vroland/epdiy/hardware/ed133ut2_connector/ed133ut2_connector.kicad_pcb

## KiCad design hardware/ed133ut2_connector/ed133ut2_connector.kicad_pcb (2020-07-25, last stored version)

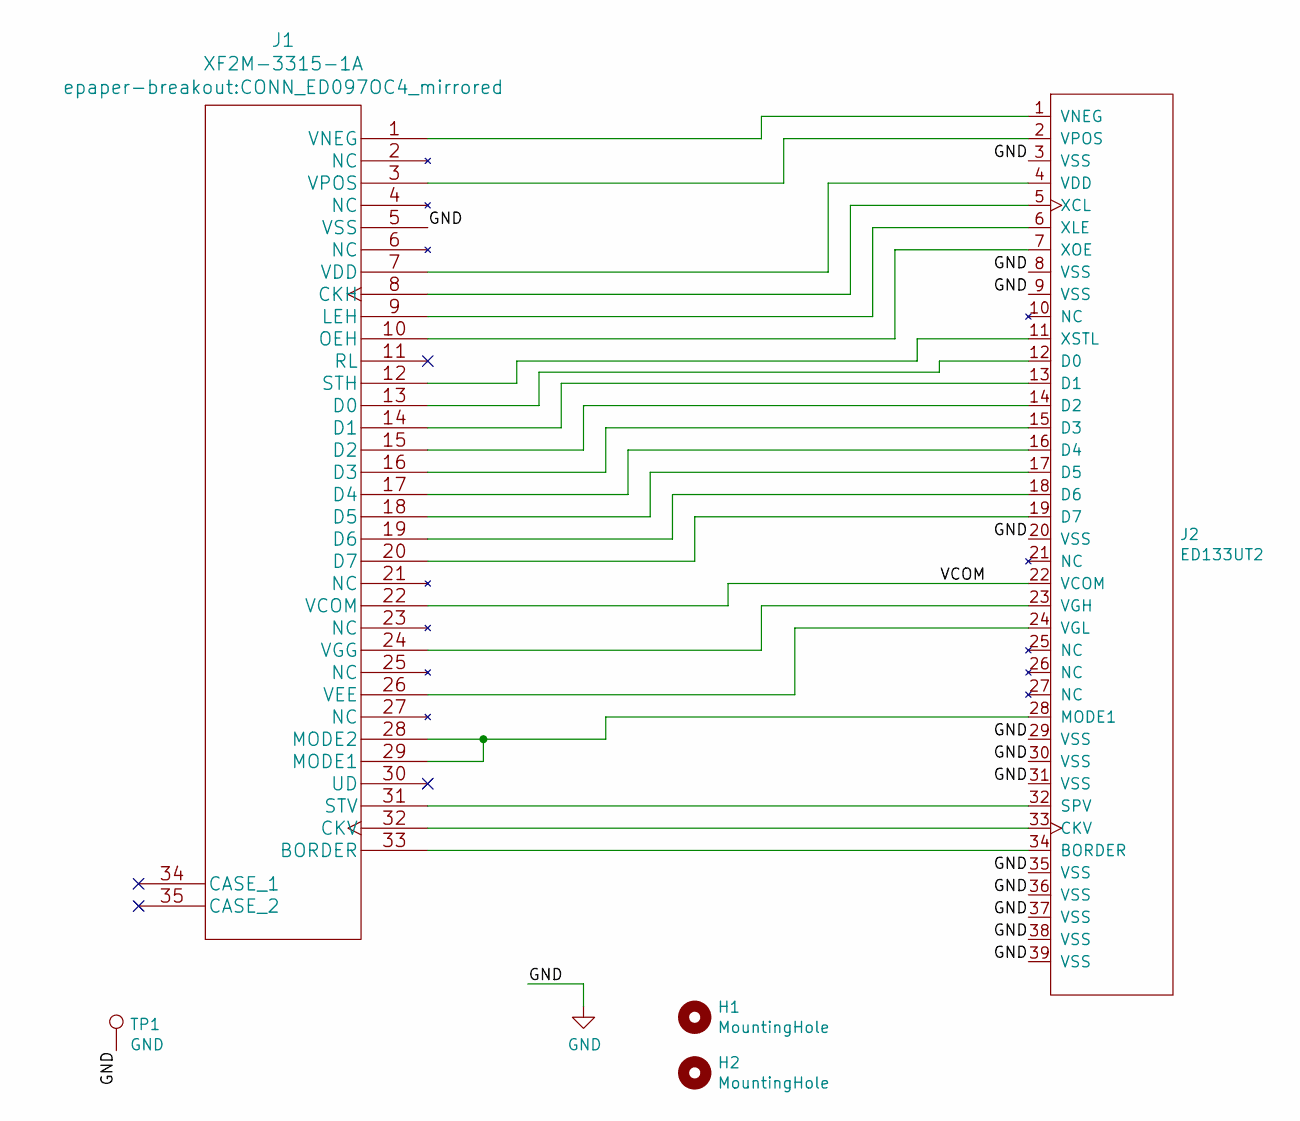
[picture p7: schematic ed133ut2_connector.sch]

Parts:
H1, H2: MountingHole; MountingHole_2.2mm_M2
J1: XF2M-3315-1A; CONN_ED097OC4_mirrored
J2: ED133UT2; HRS_FH26W-39S-0.3SHW(60)
TP1: GND; TestPoint_Pad_D2.0mm

Connections:
/VCOM: J1.22 (VCOM), J2.22 (VCOM)
GND: J1.5 (VSS), J2.3 (VSS), J2.8 (VSS), J2.9 (VSS), J2.20 (VSS), J2.29 (VSS), J2.30 (VSS), J2.31 (VSS), J2.35 (VSS), J2.36 (VSS), J2.37 (VSS), J2.38 (VSS), J2.39 (VSS), TP1.1
unnamed: J1.1 (VNEG), J2.1 (VNEG)
unnamed: J1.3 (VPOS), J2.2 (VPOS)
unnamed: J1.7 (VDD), J2.4 (VDD)
unnamed: J1.8 (CKH), J2.5 (XCL)
unnamed: J1.9 (LEH), J2.6 (XLE)
unnamed: J1.10 (OEH), J2.7 (XOE)
unnamed: J1.12 (STH), J2.11 (XSTL)
unnamed: J1.13 (D0), J2.12 (D0)
unnamed: J1.14 (D1), J2.13 (D1)
unnamed: J1.15 (D2), J2.14 (D2)
unnamed: J1.16 (D3), J2.15 (D3)
unnamed: J1.17 (D4), J2.16 (D4)
unnamed: J1.18 (D5), J2.17 (D5)
unnamed: J1.19 (D6), J2.18 (D6)
unnamed: J1.20 (D7), J2.19 (D7)
unnamed: J1.24 (VGG), J2.23 (VGH)
unnamed: J1.26 (VEE), J2.24 (VGL)
unnamed: J1.28 (MODE2), J1.29 (MODE1), J2.28 (MODE1)
unnamed: J1.31 (STV), J2.32 (SPV)
unnamed: J1.32 (CKV), J2.33 (CKV)
unnamed: J1.33 (BORDER), J2.34 (BORDER)

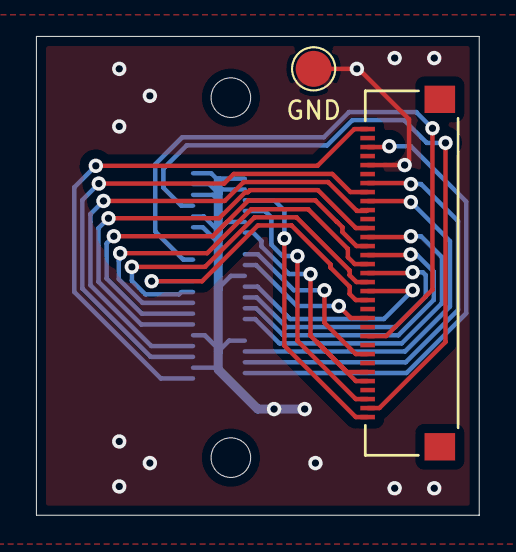
[picture p8: board ed133ut2_connector.kicad_pcb from above]

Board: 2 copper layers, 24.6 x 26.6 mm, 5 parts (1 on the bottom side), 23 nets.
